rudebacon/DesktopCleaner/DeskCleanerRobotPCB/DeskCleanerVersion2.0/Propeller.SLDPRT

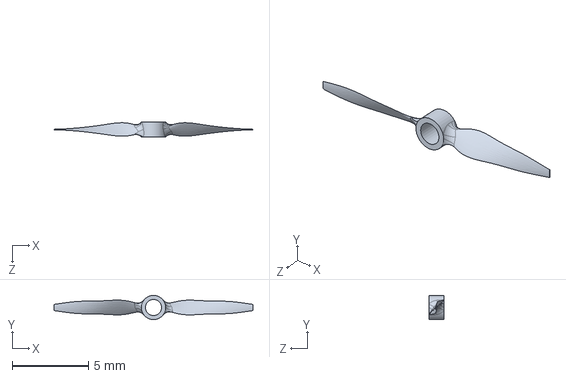
[picture p1: CAD file, 2025-05-25]
DeskCleanerRobotPCB/DeskCleanerVersion2.0/Propeller.SLDPRT
13.1 x 1.60 x 1.00 mm
