rudebacon/DesktopCleaner/DeskCleanerRobotPCB/DeskCleanerVersion2.0/motorImpellerlightversion2.SLDPRT

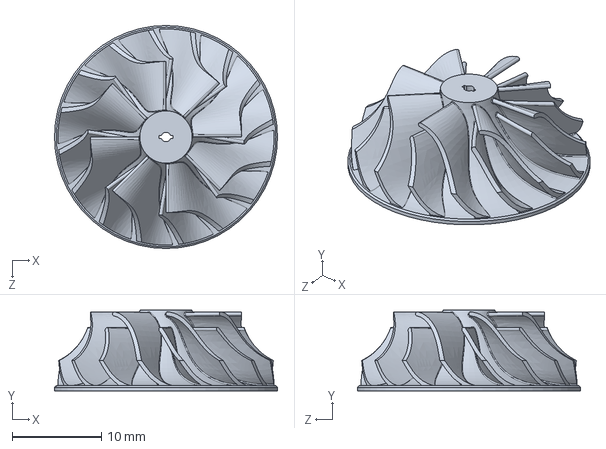
[picture p2: CAD file, 2025-05-25]
DeskCleanerRobotPCB/DeskCleanerVersion2.0/motorImpellerlightversion2.SLDPRT
25.0 x 9.04 x 25.0 mm
