rudebacon/DesktopCleaner/DeskCleanerRobotPCB/DeskCleanerVersion2.0/3.7VLipoBattery.SLDPRT

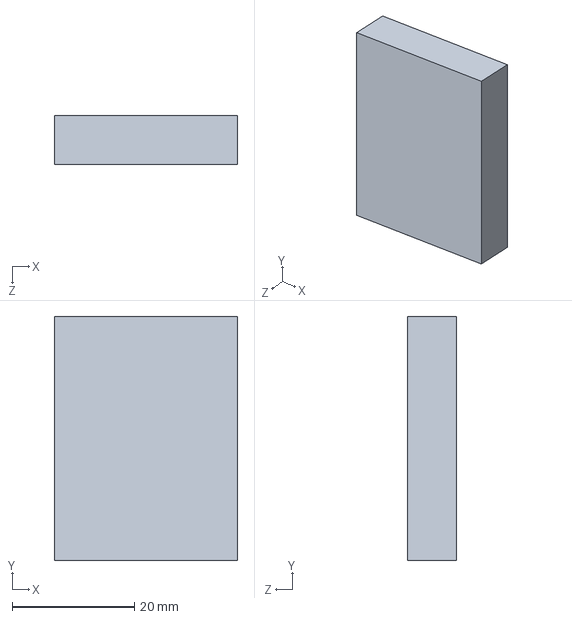
[picture p3: CAD file, 2025-05-25]
DeskCleanerRobotPCB/DeskCleanerVersion2.0/3.7VLipoBattery.SLDPRT
30.0 x 40.0 x 8.00 mm
