rudebacon/DesktopCleaner/DeskCleanerRobotPCB/DeskCleanerVersion2.0/Part2.SLDPRT

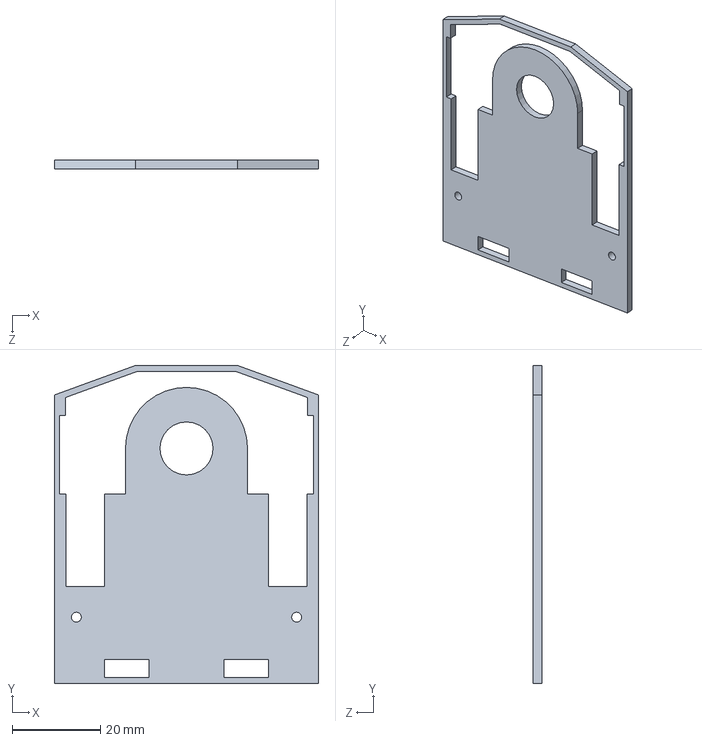
[picture p4: CAD file, 2025-05-25]
DeskCleanerRobotPCB/DeskCleanerVersion2.0/Part2.SLDPRT
59.8 x 71.9 x 2.00 mm
