rudebacon/DesktopCleaner/DeskCleanerRobotPCB/DeskCleanerVersion2.0/SE0702bldcMotor.SLDPRT

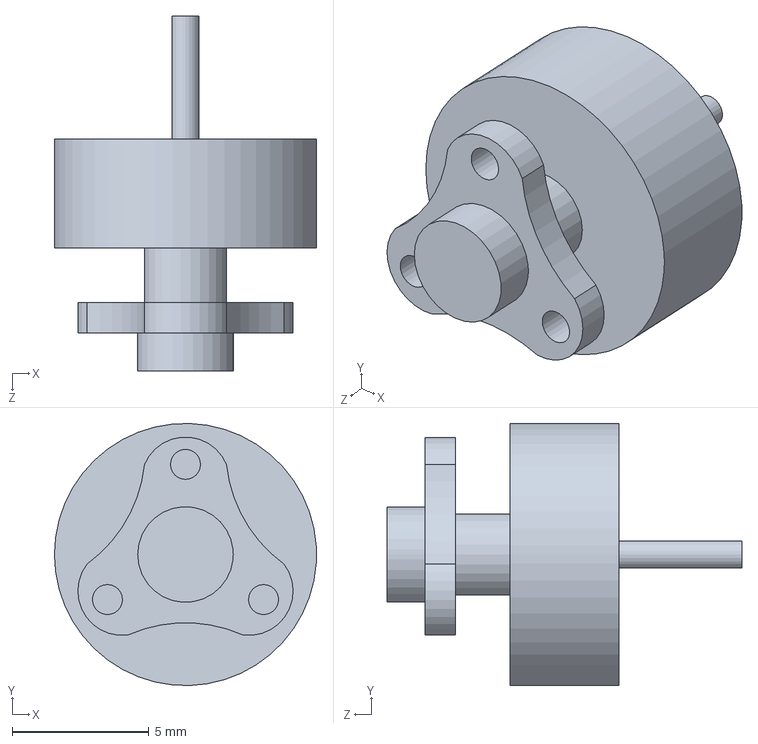
[picture p5: CAD file, 2025-05-25]
DeskCleanerRobotPCB/DeskCleanerVersion2.0/SE0702bldcMotor.SLDPRT
9.60 x 9.59 x 13.0 mm
