rudebacon/DesktopCleaner/DeskCleanerRobotPCB/DeskCleanerVersion2.0/DeskCleanerRobot_2_point_0.SLDASM

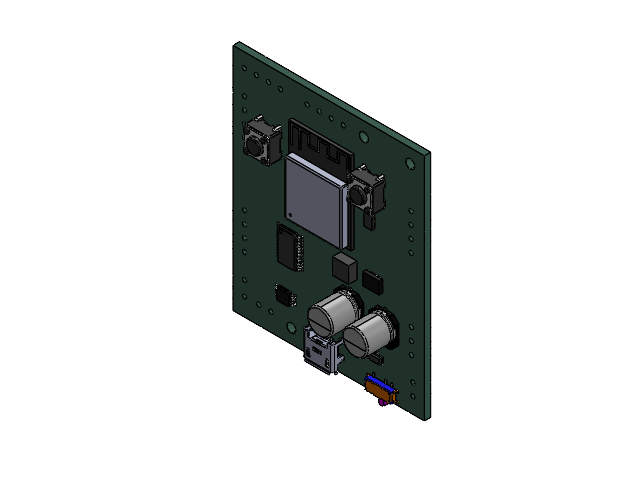
[picture p6: CAD file, 2025-05-25]
DeskCleanerRobotPCB/DeskCleanerVersion2.0/DeskCleanerRobot_2_point_0.SLDASM
PW0024A_ASM.step
DSJ0014A_ASM.step
SSSS811101-0.step
ASSEMBLY.step
DSS0012A_ASM.step
SKHHAJA010-1.step x 2
U254-05XX-4BH806.step
ASSEMBLY-2.step
__W______i____6.3 SIZE CODE D8.step x 2
ESP32-S3-MINI-1-N8-3.step
USBLC6-2P6-4.step
DGQ0010D_ASM.step
DeskCleanerRobot2_PCB.step
