rudebacon/DesktopCleaner/(list of files, cad)

Other CAD files:
DeskCleanerRobotPCB/DeskCleanerVersion2.0/LID171.SLDPRT
DeskCleanerRobotPCB/DeskCleanerVersion2.0/LID161.SLDPRT
DeskCleanerRobotPCB/DeskCleanerVersion2.0/LID68.SLDPRT
DeskCleanerRobotPCB/DeskCleanerVersion2.0/LID180.SLDPRT
DeskCleanerRobotPCB/DeskCleanerVersion2.0/LID16.SLDPRT
DeskCleanerRobotPCB/DeskCleanerVersion2.0/LID146.SLDPRT
DeskCleanerRobotPCB/DeskCleanerVersion2.0/LID4.SLDPRT
DeskCleanerRobotPCB/DeskCleanerVersion2.0/LID15.SLDPRT
DeskCleanerRobotPCB/DeskCleanerVersion2.0/LID79.SLDPRT
DeskCleanerRobotPCB/DeskCleanerVersion2.0/DustBox.SLDPRT
DeskCleanerRobotPCB/DeskCleanerVersion2.0/LID43.SLDPRT
DeskCleanerRobotPCB/DeskCleanerVersion2.0/LID186.SLDPRT
DeskCleanerRobotPCB/DeskCleanerVersion2.0/LID35.SLDPRT
DeskCleanerRobotPCB/DeskCleanerVersion2.0/LID87.SLDPRT
DeskCleanerRobotPCB/DeskCleanerVersion2.0/LID208.SLDPRT
DeskCleanerRobotPCB/DeskCleanerVersion2.0/LID57.SLDPRT
DeskCleanerRobotPCB/DeskCleanerVersion2.0/LID189.SLDPRT
DeskCleanerRobotPCB/DeskCleanerVersion2.0/LID159.SLDPRT
DeskCleanerRobotPCB/DeskCleanerVersion2.0/LID106.SLDPRT
DeskCleanerRobotPCB/DeskCleanerVersion2.0/LID20.SLDPRT
DeskCleanerRobotPCB/DeskCleanerVersion2.0/LID150.SLDPRT
DeskCleanerRobotPCB/DeskCleanerVersion2.0/LID201.SLDPRT
DeskCleanerRobotPCB/DeskCleanerVersion2.0/LID45.SLDPRT
DeskCleanerRobotPCB/DeskCleanerVersion2.0/LID18.SLDPRT
DeskCleanerRobotPCB/DeskCleanerVersion2.0/LID114.SLDPRT
DeskCleanerRobotPCB/DeskCleanerVersion2.0/LID48.SLDPRT
DeskCleanerRobotPCB/DeskCleanerVersion2.0/LID112.SLDPRT
DeskCleanerRobotPCB/DeskCleanerVersion2.0/LID149.SLDPRT
DeskCleanerRobotPCB/DeskCleanerVersion2.0/LID121.SLDPRT
DeskCleanerRobotPCB/DeskCleanerVersion2.0/LID116.SLDPRT
DeskCleanerRobotPCB/DeskCleanerVersion2.0/LID199.SLDPRT
DeskCleanerRobotPCB/DeskCleanerVersion2.0/LID134.SLDPRT
DeskCleanerRobotPCB/DeskCleanerVersion2.0/LID30.SLDPRT
DeskCleanerRobotPCB/DeskCleanerVersion2.0/LID131.SLDPRT
DeskCleanerRobotPCB/DeskCleanerVersion2.0/LID96.SLDPRT
DeskCleanerRobotPCB/DeskCleanerVersion2.0/LID119.SLDPRT
DeskCleanerRobotPCB/DeskCleanerVersion2.0/LID213.SLDPRT
DeskCleanerRobotPCB/DeskCleanerVersion2.0/LID61.SLDPRT
DeskCleanerRobotPCB/DeskCleanerVersion2.0/LID152.SLDPRT
DeskCleanerRobotPCB/DeskCleanerVersion2.0/LID139.SLDPRT
DeskCleanerRobotPCB/DeskCleanerVersion2.0/LID52.SLDPRT
DeskCleanerRobotPCB/DeskCleanerVersion2.0/LID58.SLDPRT
DeskCleanerRobotPCB/DeskCleanerVersion2.0/LID128.SLDPRT
DeskCleanerRobotPCB/DeskCleanerVersion2.0/LID42.SLDPRT
DeskCleanerRobotPCB/DeskCleanerVersion2.0/LID31.SLDPRT
DeskCleanerRobotPCB/DeskCleanerVersion2.0/LID111.SLDPRT
DeskCleanerRobotPCB/DeskCleanerVersion2.0/LID74.SLDPRT
DeskCleanerRobotPCB/DeskCleanerVersion2.0/LID120.SLDPRT
DeskCleanerRobotPCB/DeskCleanerVersion2.0/LID27.SLDPRT
DeskCleanerRobotPCB/DeskCleanerVersion2.0/LID207.SLDPRT
DeskCleanerRobotPCB/DeskCleanerVersion2.0/LID90.SLDPRT
DeskCleanerRobotPCB/DeskCleanerVersion2.0/LID130.SLDPRT
DeskCleanerRobotPCB/DeskCleanerVersion2.0/LID195.SLDPRT
DeskCleanerRobotPCB/DeskCleanerVersion2.0/FlowRegionforImpellerSimulation.SLDPRT
DeskCleanerRobotPCB/DeskCleanerVersion2.0/LID64.SLDPRT
DeskCleanerRobotPCB/DeskCleanerVersion2.0/LID163.SLDPRT
DeskCleanerRobotPCB/DeskCleanerVersion2.0/LID19.SLDPRT
DeskCleanerRobotPCB/DeskCleanerVersion2.0/LID194.SLDPRT
DeskCleanerRobotPCB/DeskCleanerVersion2.0/LID100.SLDPRT
DeskCleanerRobotPCB/DeskCleanerVersion2.0/LID216.SLDPRT
DeskCleanerRobotPCB/DeskCleanerVersion2.0/LID145.SLDPRT
DeskCleanerRobotPCB/DeskCleanerVersion2.0/LID75.SLDPRT
DeskCleanerRobotPCB/DeskCleanerVersion2.0/LID71.SLDPRT
DeskCleanerRobotPCB/DeskCleanerVersion2.0/LID118.SLDPRT
DeskCleanerRobotPCB/DeskCleanerVersion2.0/LID10.SLDPRT
DeskCleanerRobotPCB/DeskCleanerVersion2.0/LID94.SLDPRT
DeskCleanerRobotPCB/DeskCleanerVersion2.0/LID200.SLDPRT
DeskCleanerRobotPCB/DeskCleanerVersion2.0/LID188.SLDPRT
DeskCleanerRobotPCB/DeskCleanerVersion2.0/LID97.SLDPRT
DeskCleanerRobotPCB/DeskCleanerVersion2.0/LID228.SLDPRT
DeskCleanerRobotPCB/DeskCleanerVersion2.0/LID73.SLDPRT
DeskCleanerRobotPCB/DeskCleanerVersion2.0/LID166.SLDPRT
DeskCleanerRobotPCB/DeskCleanerVersion2.0/LID88.SLDPRT
DeskCleanerRobotPCB/DeskCleanerVersion2.0/LID108.SLDPRT
DeskCleanerRobotPCB/DeskCleanerVersion2.0/LID78.SLDPRT
DeskCleanerRobotPCB/DeskCleanerVersion2.0/LID147.SLDPRT
DeskCleanerRobotPCB/DeskCleanerVersion2.0/LID29.SLDPRT
DeskCleanerRobotPCB/DeskCleanerVersion2.0/LID173.SLDPRT
DeskCleanerRobotPCB/DeskCleanerVersion2.0/LID104.SLDPRT
DeskCleanerRobotPCB/DeskCleanerVersion2.0/LID81.SLDPRT
DeskCleanerRobotPCB/DeskCleanerVersion2.0/LID154.SLDPRT
DeskCleanerRobotPCB/DeskCleanerVersion2.0/LID32.SLDPRT
DeskCleanerRobotPCB/DeskCleanerVersion2.0/LID22.SLDPRT
DeskCleanerRobotPCB/DeskCleanerVersion2.0/LID24.SLDPRT
DeskCleanerRobotPCB/DeskCleanerVersion2.0/LID117.SLDPRT
DeskCleanerRobotPCB/DeskCleanerVersion2.0/LID205.SLDPRT
DeskCleanerRobotPCB/DeskCleanerVersion2.0/LID123.SLDPRT
DeskCleanerRobotPCB/DeskCleanerVersion2.0/LID126.SLDPRT
DeskCleanerRobotPCB/DeskCleanerVersion2.0/LID221.SLDPRT
DeskCleanerRobotPCB/DeskCleanerVersion2.0/LID184.SLDPRT
DeskCleanerRobotPCB/DeskCleanerVersion2.0/LID217.SLDPRT
DeskCleanerRobotPCB/DeskCleanerVersion2.0/LID132.SLDPRT
DeskCleanerRobotPCB/DeskCleanerVersion2.0/LID141.SLDPRT
DeskCleanerRobotPCB/DeskCleanerVersion2.0/LID95.SLDPRT
DeskCleanerRobotPCB/DeskCleanerVersion2.0/LID26.SLDPRT
DeskCleanerRobotPCB/DeskCleanerVersion2.0/LID137.SLDPRT
DeskCleanerRobotPCB/DeskCleanerVersion2.0/LID101.SLDPRT
DeskCleanerRobotPCB/DeskCleanerVersion2.0/LID176.SLDPRT
DeskCleanerRobotPCB/DeskCleanerVersion2.0/LID76.SLDPRT
DeskCleanerRobotPCB/DeskCleanerVersion2.0/LID37.SLDPRT
DeskCleanerRobotPCB/DeskCleanerVersion2.0/LID129.SLDPRT
DeskCleanerRobotPCB/DeskCleanerVersion2.0/LID187.SLDPRT
DeskCleanerRobotPCB/DeskCleanerVersion2.0/LID54.SLDPRT
DeskCleanerRobotPCB/DeskCleanerVersion2.0/LID21.SLDPRT
DeskCleanerRobotPCB/DeskCleanerVersion2.0/LID122.SLDPRT
DeskCleanerRobotPCB/DeskCleanerVersion2.0/LID190.SLDPRT
DeskCleanerRobotPCB/DeskCleanerVersion2.0/LID5.SLDPRT
DeskCleanerRobotPCB/DeskCleanerVersion2.0/LID56.SLDPRT
DeskCleanerRobotPCB/DeskCleanerVersion2.0/LID135.SLDPRT
DeskCleanerRobotPCB/DeskCleanerVersion2.0/LID183.SLDPRT
DeskCleanerRobotPCB/DeskCleanerVersion2.0/LID49.SLDPRT
DeskCleanerRobotPCB/DeskCleanerVersion2.0/LID14.SLDPRT
DeskCleanerRobotPCB/DeskCleanerVersion2.0/LID167.SLDPRT
DeskCleanerRobotPCB/DeskCleanerVersion2.0/LID219.SLDPRT
DeskCleanerRobotPCB/DeskCleanerVersion2.0/LID162.SLDPRT
DeskCleanerRobotPCB/DeskCleanerVersion2.0/LID144.SLDPRT
DeskCleanerRobotPCB/DeskCleanerVersion2.0/LID91.SLDPRT
DeskCleanerRobotPCB/DeskCleanerVersion2.0/LID142.SLDPRT
DeskCleanerRobotPCB/DeskCleanerVersion2.0/LID220.SLDPRT
DeskCleanerRobotPCB/DeskCleanerVersion2.0/LID143.SLDPRT
DeskCleanerRobotPCB/DeskCleanerVersion2.0/LID98.SLDPRT
DeskCleanerRobotPCB/DeskCleanerVersion2.0/LID44.SLDPRT
DeskCleanerRobotPCB/DeskCleanerVersion2.0/LID59.SLDPRT
DeskCleanerRobotPCB/DeskCleanerVersion2.0/LID191.SLDPRT
DeskCleanerRobotPCB/DeskCleanerVersion2.0/LID197.SLDPRT
DeskCleanerRobotPCB/DeskCleanerVersion2.0/LID28.SLDPRT
DeskCleanerRobotPCB/DeskCleanerVersion2.0/LID92.SLDPRT
DeskCleanerRobotPCB/DeskCleanerVersion2.0/LID222.SLDPRT
DeskCleanerRobotPCB/DeskCleanerVersion2.0/LID172.SLDPRT
DeskCleanerRobotPCB/DeskCleanerVersion2.0/LID226.SLDPRT
DeskCleanerRobotPCB/DeskCleanerVersion2.0/LID165.SLDPRT
DeskCleanerRobotPCB/DeskCleanerVersion2.0/LID193.SLDPRT
DeskCleanerRobotPCB/DeskCleanerVersion2.0/LID115.SLDPRT
DeskCleanerRobotPCB/DeskCleanerVersion2.0/LID105.SLDPRT
DeskCleanerRobotPCB/DeskCleanerVersion2.0/LID125.SLDPRT
DeskCleanerRobotPCB/DeskCleanerVersion2.0/LID103.SLDPRT
DeskCleanerRobotPCB/DeskCleanerVersion2.0/LID202.SLDPRT
DeskCleanerRobotPCB/DeskCleanerVersion2.0/LID109.SLDPRT
DeskCleanerRobotPCB/DeskCleanerVersion2.0/LID25.SLDPRT
DeskCleanerRobotPCB/DeskCleanerVersion2.0/LID72.SLDPRT
DeskCleanerRobotPCB/DeskCleanerVersion2.0/Wheel.SLDPRT
DeskCleanerRobotPCB/DeskCleanerVersion2.0/LID203.SLDPRT
DeskCleanerRobotPCB/DeskCleanerVersion2.0/LID40.SLDPRT
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
