rudebacon/DesktopCleaner/DeskCleanerRobotPCB/DeskCleanerVersion2.0/VCNL4040Breakout2.kicad_pcb

## KiCad design DeskCleanerRobotPCB/DeskCleanerVersion2.0/VCNL4040Breakout2.kicad_pcb (2025-05-25)

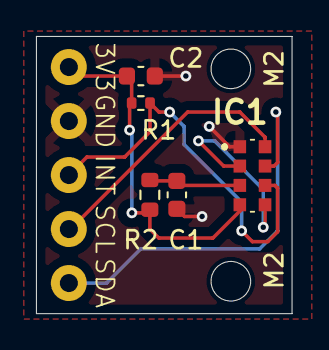
[picture p7: board VCNL4040Breakout2.kicad_pcb from above]

Board: 2 copper layers, 14.2 x 15.4 mm, 12 parts (0 on the bottom side), 7 nets.

Parts:
3V3: +3.3V; Soldering_Holes_1mmH_2mmPad
C1: 0.1uF; C_0603_1608Metric
C2: 2.2uF; C_0603_1608Metric
GND: GND; Soldering_Holes_1mmH_2mmPad
IC1: VCNL4040M3OE
INT: INT1; Soldering_Holes_1mmH_2mmPad
M2, M2#2: MountingHole_2.2mm_M2
R1: 8.2k; R_0402_1005Metric
R2: 22; R_0603_1608Metric
SCL: SCL; Soldering_Holes_1mmH_2mmPad
SDA: SDA; Soldering_Holes_1mmH_2mmPad

Connections:
GND: C1.2, C2.2, GND.1, IC1.1 (GND)
unnamed: 3V3.1, C2.1, IC1.4 (A), R1.1, R2.2
unnamed: IC1.6 (INT), INT.1, R1.2
unnamed: IC1.2 (K(SENSOR)), IC1.5 (K(LED))
unnamed: IC1.8 (SCLK), SCL.1
unnamed: IC1.7 (SDAT), SDA.1
unnamed: C1.1, IC1.3 (VDD), R2.1
