rudebacon/DesktopCleaner/DeskCleanerRobotPCB/DeskCleanerVersion2.0/DeskCleanerRobot2.kicad_pcb

## KiCad design DeskCleanerRobotPCB/DeskCleanerVersion2.0/DeskCleanerRobot2.kicad_pcb (2025-05-25)

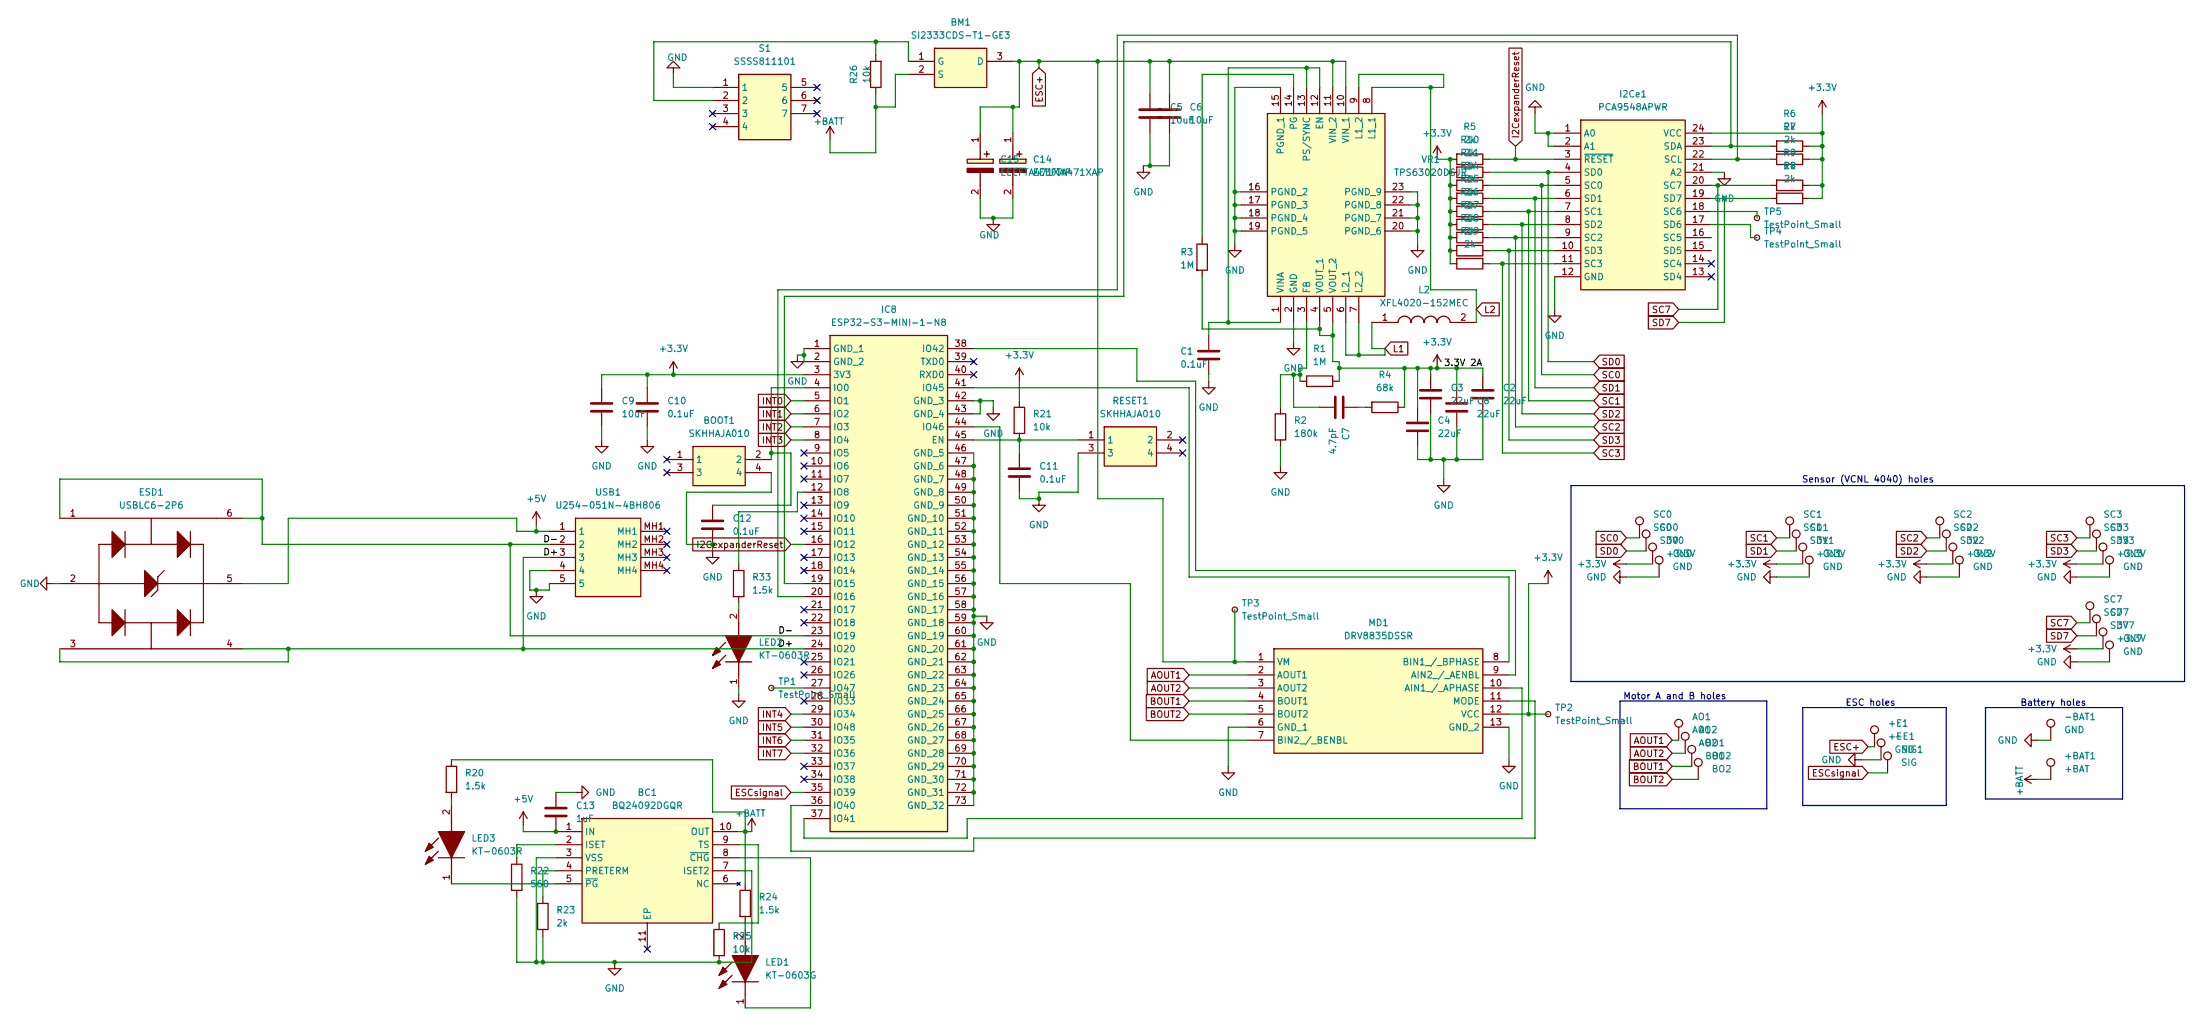
[picture p8: schematic DeskCleanerRobot2.kicad_sch]

Parts:
3V0, 3V1, 3V2, 3V3, 3V7: +3.3V; Soldering_Holes_1mmH_2mmPad
+BAT1: +BAT; Soldering_Holes_1mmH_2mmPad
+E1: +E; Soldering_Holes_1mmH_2mmPad
-BAT1: GND; Soldering_Holes_1mmH_2mmPad
-E1: GND; Soldering_Holes_1mmH_2mmPad
AO1: AO1; Soldering_Holes_1mmH_2mmPad
AO2: AO2; Soldering_Holes_1mmH_2mmPad
BC1: BQ24092DGQR; SOP50P490X110-11N; Manufacturer_Part_Number BQ24092DGQR; Mouser Part Number 595-BQ24092DGQR
BM1: SI2333CDS-T1-GE3; SOT95P237X112-3N; Manufacturer_Part_Number SI2333CDS-T1-GE3
BO1: BO1; Soldering_Holes_1mmH_2mmPad
BO2: BO2; Soldering_Holes_1mmH_2mmPad
BOOT1: SKHHAJA010; SKHHALA010; Manufacturer_Part_Number SKHHAJA010; Mouser Part Number 688-SKHHAJ
C1, C10, C11, C12: 0.1uF; C_0603_1608Metric
C2, C3, C4, C8: 22uF; C_0603_1608Metric
C5, C6, C9: 10uF; C_0603_1608Metric
C7: 4.7pF; C_0603_1608Metric
C13: 1uF; C_0603_1608Metric
C14, C15: EEEFTA471XAP; EEE0JA331XP; Manufacturer_Part_Number EEEFTA471XAP
ESD1: USBLC6-2P6; USBLC62P6; Manufacturer_Part_Number USBLC6-2P6; Mouser Part Number 511-USBLC6-2P6
GN0, GN1, GN2, GN3, GN7: GND; Soldering_Holes_1mmH_2mmPad
I2Ce1: PCA9548APWR; SOP65P640X120-24N; Manufacturer_Part_Number PCA9548APWR; Mouser Part Number 595-PCA9548APWR
IC8: ESP32-S3-MINI-1-N8; ESP32S3MINI1N8; Manufacturer_Part_Number ESP32-S3-MINI-1-N8; Mouser Part Number 356-ESP32-S3-MINI1N8
L2: XFL4020-152MEC; XFL4020152MEC; Manufacturer_Part_Number XFL4020-152MEC; Mouser Part Number 994-XFL4020-152MEC
LED1: KT-0603G; LEDC1608X70N; Manufacturer_Part_Number KT-0603R
LED2, LED3: KT-0603R; LEDC1608X70N; Manufacturer_Part_Number KT-0603R
MD1: DRV8835DSSR; Manufacturer_Part_Number DRV8835DSSR; Mouser Part Number 595-DRV8835DSSR
R1, R3: 1M; R_0603_1608Metric
R2: 180k; R_0603_1608Metric
R4: 68k; R_0603_1608Metric
R5, R6, R7, R8, R9, R10, R11, R14, R15, R16, R17, R18, R19, R23: 2k; R_0402_1005Metric
R20, R24, R33: 1.5k; R_0402_1005Metric
R21, R25, R26: 10k; R_0402_1005Metric
R22: 560; R_0402_1005Metric
RESET1: SKHHAJA010; SKHHALA010; Manufacturer_Part_Number SKHHAJA010; Mouser Part Number 688-SKHHAJ
S1: SSSS811101; Manufacturer_Part_Number SSSS811101; Mouser Part Number 688-SSSS811101
SC0: SC0; Soldering_Holes_1mmH_2mmPad
SC1: SC1; Soldering_Holes_1mmH_2mmPad
SC2: SC2; Soldering_Holes_1mmH_2mmPad
SC3: SC3; Soldering_Holes_1mmH_2mmPad
SC7: SC7; Soldering_Holes_1mmH_2mmPad
SD0: SD0; Soldering_Holes_1mmH_2mmPad
SD1: SD1; Soldering_Holes_1mmH_2mmPad
SD2: SD2; Soldering_Holes_1mmH_2mmPad
SD3: SD3; Soldering_Holes_1mmH_2mmPad
SD7: SD7; Soldering_Holes_1mmH_2mmPad
SIG1: SIG; Soldering_Holes_1mmH_2mmPad
TP1, TP2, TP3, TP4, TP5: TestPoint_Small; TestPoint_Pad_1.0x1.0mm
USB1: U254-051N-4BH806; U254051N4BH806; Manufacturer_Part_Number U254-051N-4BH806
VR1: TPS63020DSJR; Manufacturer_Part_Number TPS63020DSJR; Mouser Part Number 595-TPS63020DSJR

Connections:
+3.3V: 3V0.1, 3V1.1, 3V2.1, 3V3.1, 3V7.1, C2.1, C3.1, C4.1, C8.1, C9.1, C10.1, I2Ce1.24 (VCC), IC8.3 (3V3), MD1.12 (VCC), R1.2, R3.2, R4.1, R5.2, R6.1, R7.1, R8.1, R9.1, R10.2, R11.2, R14.2, R15.2, R16.2, R17.2, R18.2, R19.2, R21.1, TP2.1, VR1.4 (VOUT_1), VR1.5 (VOUT_2)
+5V: BC1.1 (IN), C13.2, ESD1.5 (VBUS), USB1.1
+BATT: +BAT1.1, BC1.10 (OUT), BM1.2 (S), R20.1, R24.1, R26.1
/D+: ESD1.3 (I/O2_1), ESD1.4 (I/O2_2), IC8.24 (IO20), USB1.3
/D-: ESD1.1 (I/O1_1), ESD1.6 (I/O1_2), IC8.23 (IO19), USB1.2
AOUT1: AO1.1, MD1.2 (AOUT1)
AOUT2: AO2.1, MD1.3 (AOUT2)
BOUT1: BO1.1, MD1.4 (BOUT1)
BOUT2: BO2.1, MD1.5 (BOUT2)
ESC+: +E1.1, BM1.3 (D), C5.1, C6.1, C14.1 (+), C15.1 (+), MD1.1 (VM), TP3.1, VR1.10 (VIN_1), VR1.11 (VIN_2)
ESCsignal: IC8.35 (IO39), SIG1.1
GND: -BAT1.1, -E1.1, BC1.3 (VSS), BC1.7 (ISET2), BOOT1.4, C1.2, C2.2, C3.2, C4.2, C5.2, C6.2, C8.2, C9.2, C10.2, C11.2, C12.2, C13.1, C14.2 (-), C15.2 (-), ESD1.2 (GND), GN0.1, GN1.1, GN2.1, GN3.1, GN7.1, I2Ce1.1 (A0), I2Ce1.2 (A1), I2Ce1.12 (GND), I2Ce1.21 (A2), IC8.1 (GND_1), IC8.2 (GND_2), IC8.42 (GND_3), IC8.43 (GND_4), IC8.46 (GND_5), IC8.47 (GND_6), IC8.48 (GND_7), IC8.49 (GND_8), IC8.50 (GND_9), IC8.51 (GND_10), IC8.52 (GND_11), IC8.53 (GND_12), IC8.54 (GND_13), IC8.55 (GND_14), IC8.56 (GND_15), IC8.57 (GND_16), IC8.58 (GND_17), IC8.59 (GND_18), IC8.60 (GND_19), IC8.61 (GND_20), IC8.62 (GND_21), IC8.63 (GND_22), IC8.64 (GND_23), IC8.65 (GND_24), IC8.66 (GND_25), IC8.67 (GND_26), IC8.68 (GND_27), IC8.69 (GND_28), IC8.70 (GND_29), IC8.71 (GND_30), IC8.72 (GND_31), IC8.73 (GND_32), LED2.1 (K), MD1.6 (GND_1), MD1.13 (GND_2), R2.2, R22.2, R23.2, R25.2, RESET1.3, S1.1, USB1.4, USB1.5, VR1.2 (GND), VR1.15 (PGND_1), VR1.16 (PGND_2), VR1.17 (PGND_3), VR1.18 (PGND_4), VR1.19 (PGND_5), VR1.20 (PGND_6), VR1.21 (PGND_7), VR1.22 (PGND_8), VR1.23 (PGND_9)
I2CexpanderReset: I2Ce1.3 (~RESET), IC8.16 (IO12), R5.1
INT0: IC8.5 (IO1)
INT1: IC8.6 (IO2)
INT2: IC8.7 (IO3)
INT3: IC8.8 (IO4)
INT4: IC8.29 (IO34)
INT5: IC8.30 (IO48)
INT6: IC8.31 (IO35)
INT7: IC8.32 (IO36)
L1: L2.1, VR1.6 (L2_1), VR1.7 (L2_2)
L2: L2.2, VR1.8 (L1_1), VR1.9 (L1_2)
unnamed: BC1.2 (ISET), R22.1
unnamed: BC1.4 (PRETERM), R23.1
unnamed: BC1.9 (TS), R25.1
unnamed: BC1.8 (~CHG), LED1.1 (K)
unnamed: BC1.5 (~PG), LED3.1 (K)
unnamed: BM1.1 (G), R26.2, S1.2
unnamed: C7.1, R4.2
unnamed: I2Ce1.18 (SC6), TP5.1
unnamed: I2Ce1.22 (SCL), IC8.20 (IO16), R7.2
unnamed: I2Ce1.17 (SD6), TP4.1
unnamed: I2Ce1.23 (SDA), IC8.19 (IO15), R6.2
unnamed: C11.1, IC8.45 (EN), R21.2, RESET1.1
unnamed: BOOT1.2, C12.1, IC8.4 (IO0)
unnamed: IC8.12 (IO8), R33.1
unnamed: IC8.36 (IO40), MD1.11 (MODE)
unnamed: IC8.37 (IO41), MD1.10 (AIN1_/_APHASE)
unnamed: IC8.38 (IO42), MD1.9 (AIN2_/_AENBL)
unnamed: IC8.41 (IO45), MD1.8 (BIN1_/_BPHASE)
unnamed: IC8.44 (IO46), MD1.7 (BIN2_/_BENBL)
unnamed: IC8.27 (IO47), TP1.1
unnamed: LED1.2 (A), R24.2
unnamed: LED2.2 (A), R33.2
unnamed: LED3.2 (A), R20.2
unnamed: C1.1, VR1.1 (VINA), VR1.12 (EN), VR1.13 (PS/SYNC)
unnamed: C7.2, R1.1, R2.1, VR1.3 (FB)
unnamed: R3.1, VR1.14 (PG)
SC0: I2Ce1.5 (SC0), R11.1, SC0.1
SC1: I2Ce1.7 (SC1), R15.1, SC1.1
SC2: I2Ce1.9 (SC2), R17.1, SC2.1
SC3: I2Ce1.11 (SC3), R19.1, SC3.1
SC7: I2Ce1.20 (SC7), R9.2, SC7.1
SD0: I2Ce1.4 (SD0), R10.1, SD0.1
SD1: I2Ce1.6 (SD1), R14.1, SD1.1
SD2: I2Ce1.8 (SD2), R16.1, SD2.1
SD3: I2Ce1.10 (SD3), R18.1, SD3.1
SD7: I2Ce1.19 (SD7), R8.2, SD7.1

Notes on the sheet:
Sensor (VCNL 4040) holes
ESC holes
Battery holes
Motor A and B holes

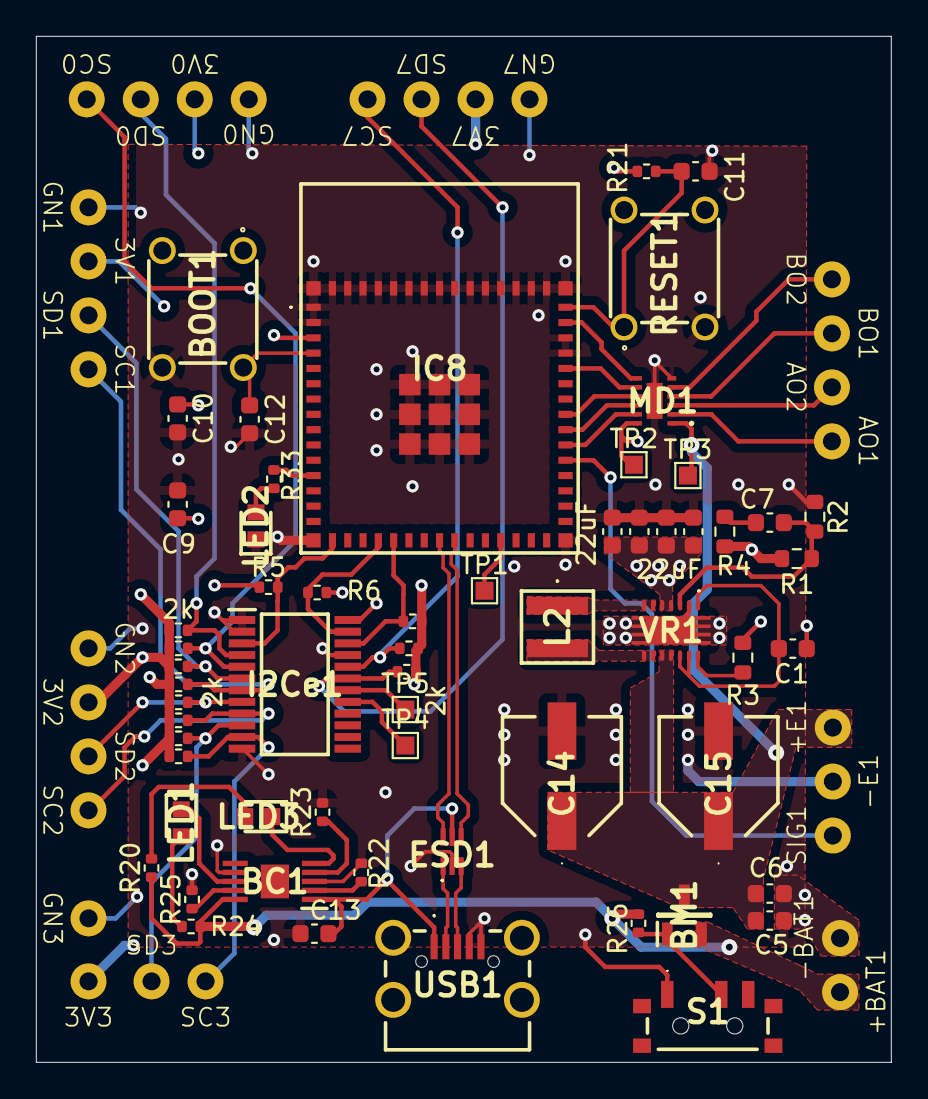
[picture p9: board DeskCleanerRobot2.kicad_pcb from above]

Board: 4 copper layers, 47.5 x 57.0 mm, 89 parts (0 on the bottom side), 51 nets.
