rudebacon/DesktopCleaner/(commit log)

2024-12-19 Create DeskCleanerRobotPCB.ino
    Two sensors working but connection is finnicky so sometimes have to reset to get sensor 1/channel 0 "unstuck"
    [DeskCleanerRobotPCB.ino]
2025-05-25 moved other files in
    [3.7VLipoBattery.SLDPRT, Cover.SLDPRT, Cover.STL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]
